solarmon/FlashFloppy/FF OSD Adapter - Rev 2/FF OSD Adapter - Rev 2.pdf

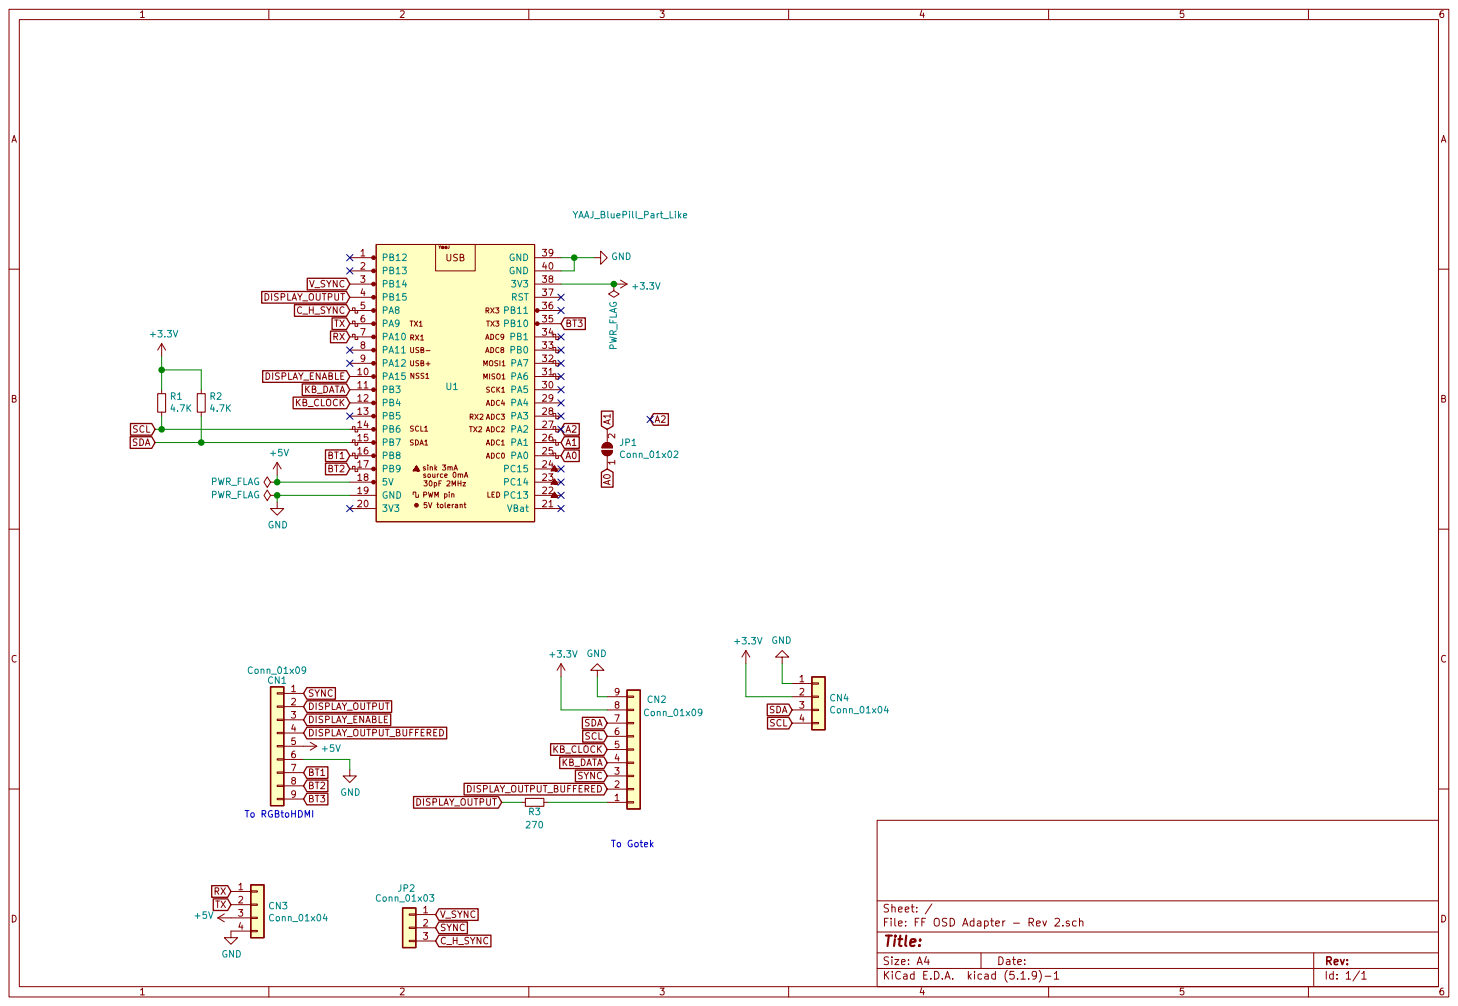
[picture p4: page 1]
