solarmon/FlashFloppy/FF OSD Adapter/FF OSD Adapter.pdf

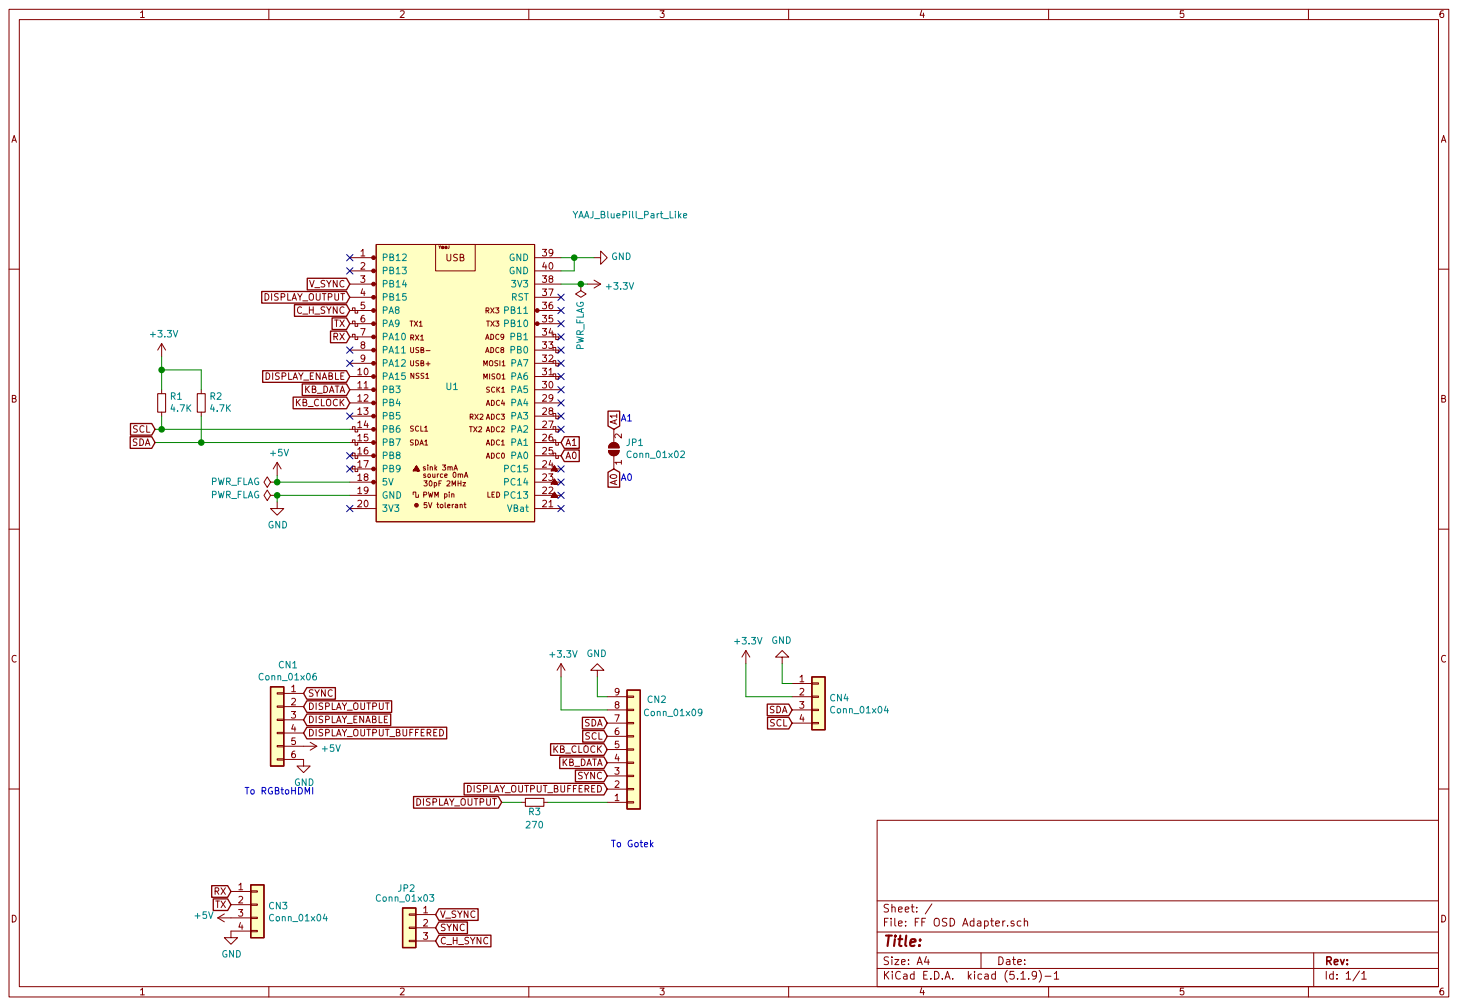
[picture p5: page 1]

File: FF OSD Adapter.sch Sheet: / R3
