solarmon/FlashFloppy/FF OSD Adapter - Rev 2/FF OSD Adapter - Rev 2.kicad_pcb

## KiCad design FF OSD Adapter - Rev 2/FF OSD Adapter - Rev 2.kicad_pcb (2021-05-19)

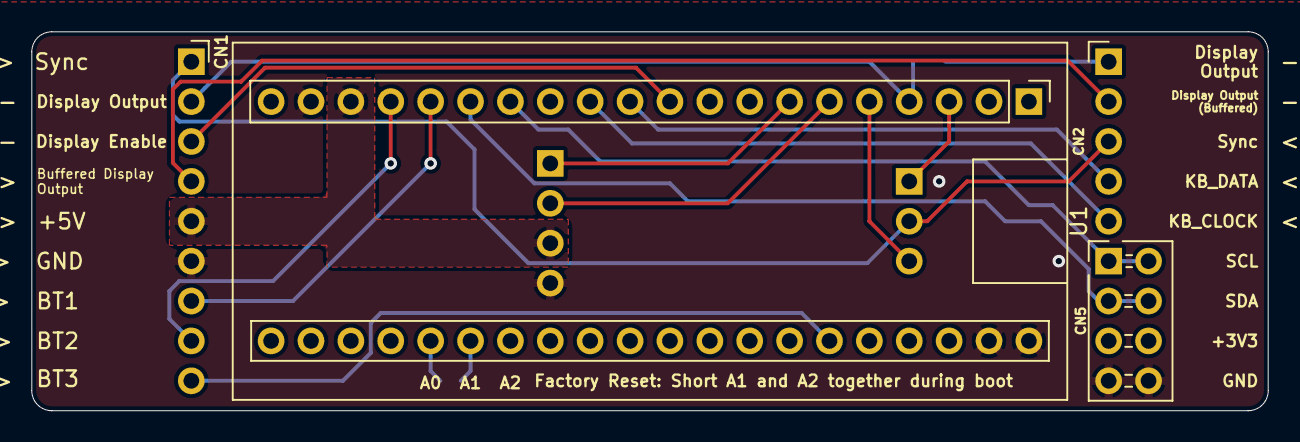
[picture p6: board FF OSD Adapter - Rev 2.kicad_pcb from above]

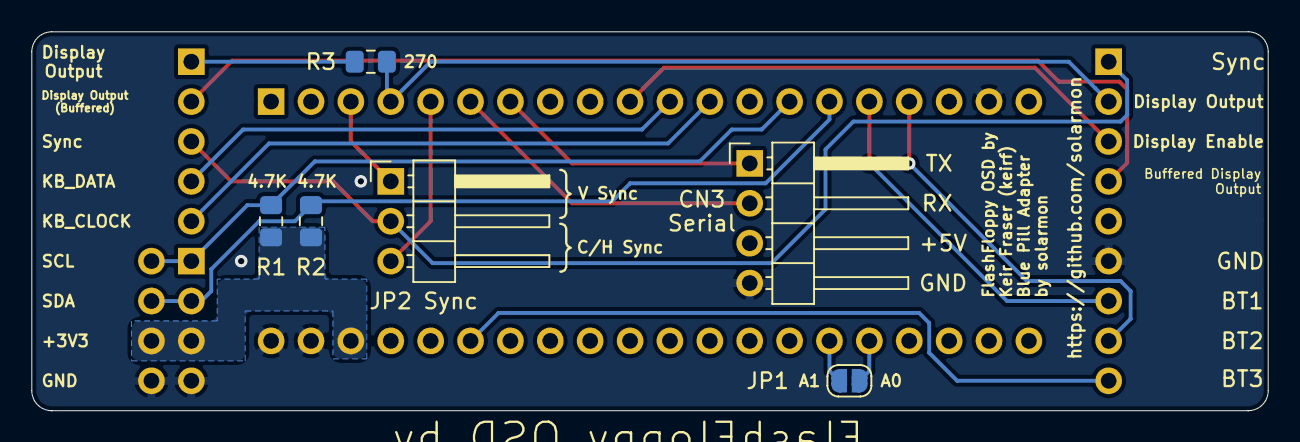
[picture p7: board FF OSD Adapter - Rev 2.kicad_pcb from below]

Board: 2 copper layers, 78.7 x 24.1 mm, 10 parts (6 on the bottom side), 21 nets.

Parts:
CN1: Conn_01x09; PinSocket_1x09_P2.54mm_Horizontal
CN2: Conn_01x05; PinHeader_1x05_P2.54mm_Horizontal
CN3: Conn_01x04; PinHeader_1x04_P2.54mm_Horizontal
CN5: Conn_02x04_Row_Letter_First; PinHeader_2x04_P2.54mm_Horizontal
JP1: Conn_01x02; SolderJumper-2_P1.3mm_Open_RoundedPad1.0x1.5mm
JP2: Conn_01x03; PinHeader_1x03_P2.54mm_Horizontal
R1, R2: 4.7K; R_0805_2012Metric_Pad1.15x1.40mm_HandSolder
R3: 270; R_0805_2012Metric_Pad1.15x1.40mm_HandSolder
U1: YAAJ_BluePill_Part_Like; YAAJ_BluePill_2

Connections:
+3V3: CN5.5, CN5.6, R1.2, R2.2, U1.38
+5V: CN1.5, CN3.3, U1.18
A0: JP1.1, U1.25
A1: JP1.2, U1.26
BT1: CN1.7, U1.16
BT2: CN1.8, U1.17
BT3: CN1.9, U1.35
C_H_SYNC: JP2.3, U1.5
DISPLAY_ENABLE: CN1.3, U1.10
DISPLAY_OUTPUT: CN1.2, R3.1, U1.4
DISPLAY_OUTPUT_BUFFERED: CN1.4, CN2.2
GND: CN1.6, CN3.4, CN5.7, CN5.8, U1.19, U1.39, U1.40
KB_CLOCK: CN2.5, U1.12
KB_DATA: CN2.4, U1.11
unnamed: CN2.1, R3.2
RX: CN3.1, U1.7
SCL: CN5.1, CN5.2, R1.1, U1.14
SDA: CN5.3, CN5.4, R2.1, U1.15
SYNC: CN1.1, CN2.3, JP2.2
TX: CN3.2, U1.6
V_SYNC: JP2.1, U1.3
