solarmon/FlashFloppy/(commit log)

2021-04-10 Added FF OSD Adapter
    [FF OSD Adapter-B_Cu.gbr, FF OSD Adapter-B_Mask.gbr, FF OSD Adapter-B_Paste.gbr, FF OSD Adapter-B_SilkS.gbr, FF OSD Adapter-Edge_Cuts.gbr, FF OSD Adapter-F_Cu.gbr, FF OSD Adapter-F_Mask.gbr, FF OSD Adapter-F_Paste.gbr]
2021-04-10 Updated link to Blue Pill 3D model
    [FF OSD Adapter.kicad_pcb]
2021-05-16 Added PNG and PDF files
    [FF OSD Adapter.sch]
2021-05-16 Added "FF OSD Adapter - Rev 2" project
    [FF OSD Adapter - Rev 2-B_Cu.gbr, FF OSD Adapter - Rev 2-B_Mask.gbr, FF OSD Adapter - Rev 2-B_Paste.gbr, FF OSD Adapter - Rev 2-B_SilkS.gbr, FF OSD Adapter - Rev 2-Edge_Cuts.gbr, FF OSD Adapter - Rev 2-F_Cu.gbr, FF OSD Adapter - Rev 2-F_Mask.gbr, FF OSD Adapter - Rev 2-F_Paste.gbr]
2021-05-16 Added PND and PDF files
    [FF OSD Adapter - Rev 2.sch]
2021-05-19 Updated schematic and board to show the I2C display pins better
    [FF OSD Adapter - Rev 2-B_Cu.gbr, FF OSD Adapter - Rev 2-B_Mask.gbr, FF OSD Adapter - Rev 2-B_Paste.gbr, FF OSD Adapter - Rev 2-B_SilkS.gbr, FF OSD Adapter - Rev 2-Edge_Cuts.gbr, FF OSD Adapter - Rev 2-F_Cu.gbr, FF OSD Adapter - Rev 2-F_Mask.gbr, FF OSD Adapter - Rev 2-F_Paste.gbr]
2021-05-19 Updated schematics
    [FF OSD Adapter - Rev 2.sch]
